Minty245/Steam-Frame-Ambilight/firmware/oal_led_udp/wifi_secrets.example.h

// Copy this file to wifi_secrets.h (in the same folder) and fill in your network.
// wifi_secrets.h is git-ignored so your password doesn't end up in the repository.
// The ESP32 only supports 2.4 GHz Wi-Fi.
#pragma once
#define WIFI_SSID     "your-network-name"
#define WIFI_PASSWORD "your-password"
